W4KRL/EBikeLogger/images/E-Bike-Logger-schematic.jpg

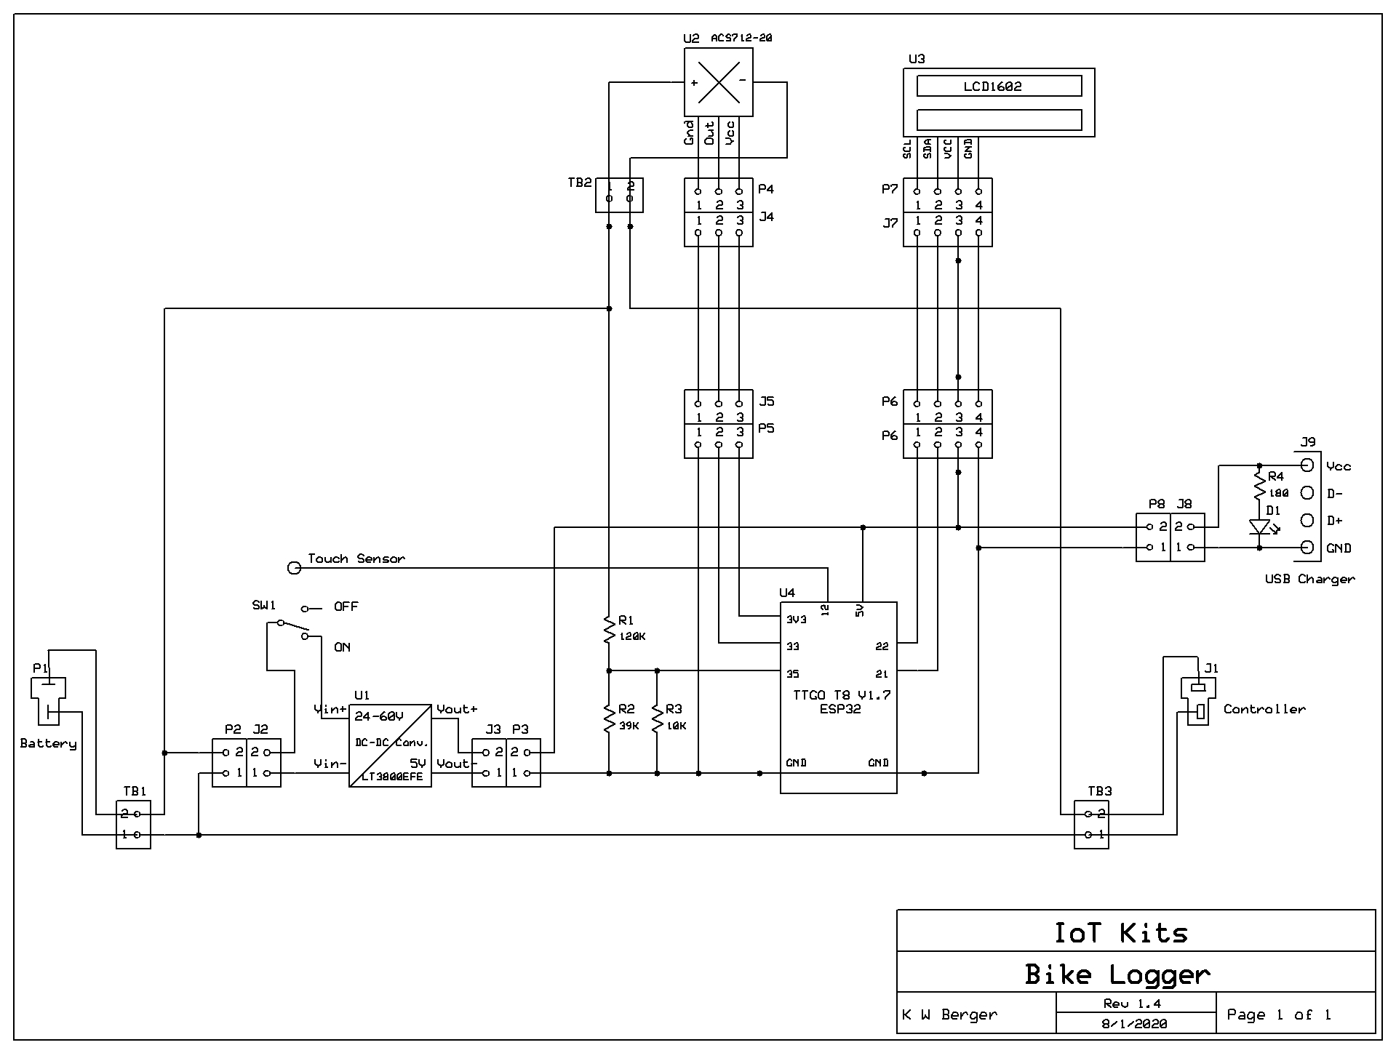
images/E-Bike-Logger-schematic.jpg
