W4KRL/EBikeLogger/(commit log)

2020-08-10 Add schematic
2020-08-10 Create ESP32-bike-monitor-OTA.ino
    ESP32/Arduino main file
2020-08-10 Create barGraphSymbols.h
    LCD symbol file for ESP32-bike-monitor-OTA.ino
2020-08-10 Create ESP32-bike-monitor.ino
    Non-OTA version
